moeburn/seansmeatthermometer/frzmain.jpg

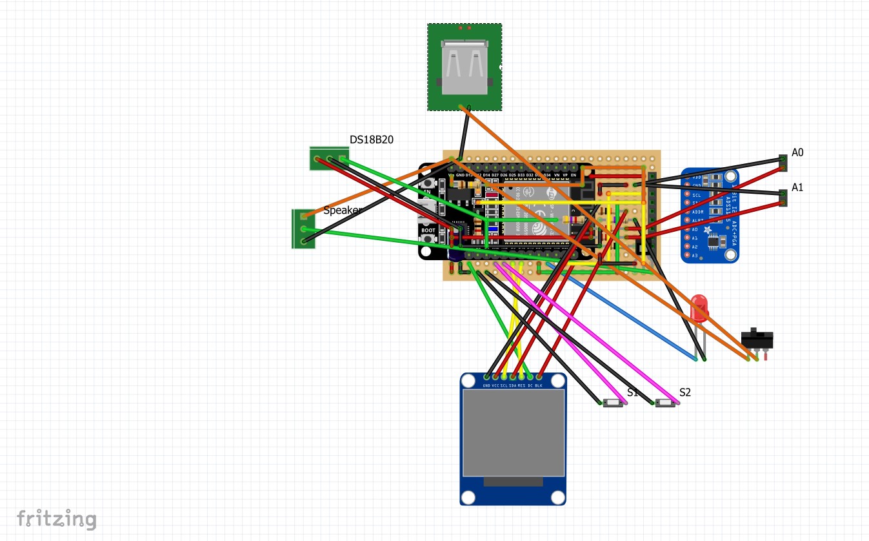
frzmain.jpg
