moeburn/seansmeatthermometer/frzLM386.jpg

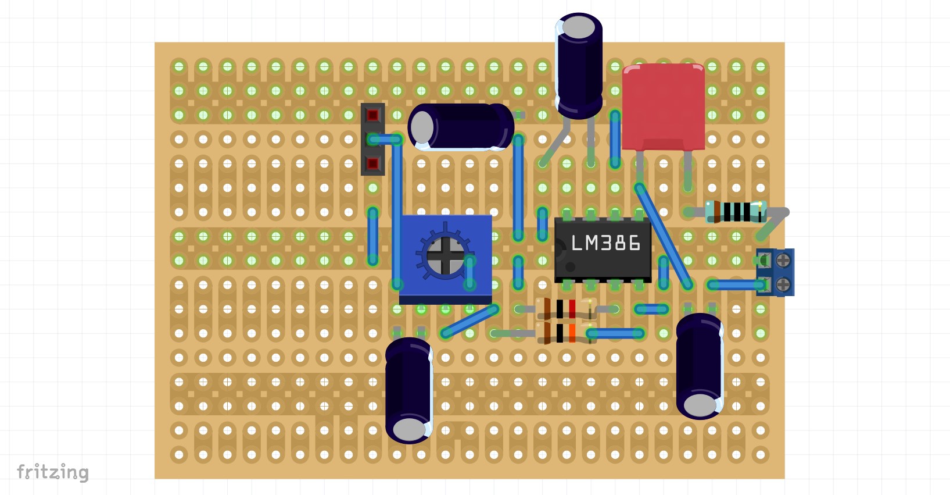
frzLM386.jpg
