moeburn/seansmeatthermometer/frzLM386schematic.jpg

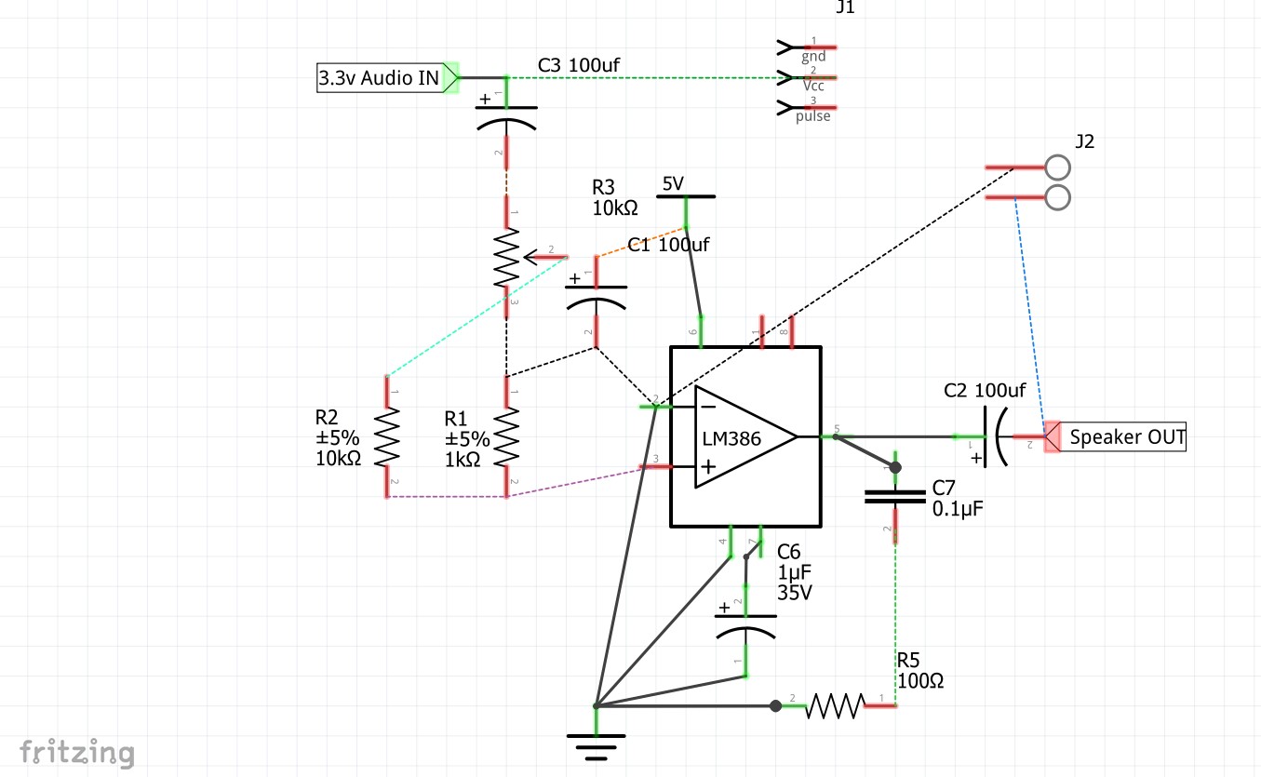
frzLM386schematic.jpg
