moeburn/seansmeatthermometer/(list of files, drawings)

Other design files:
lm386.fzz
sean.fzz
