moeburn/seansmeatthermometer/(commit log)

2024-06-27 debug stage 1
2024-07-01 fix steinhart-hart bug giving slightly incorrect temperatures
    apparently you actually have to input resistance in ohms, and not just any random-ass ADC count value, or you'll get temperatures but they'll be just a bit off. Who knew.
    [seanmeatthermometer.ino]
2024-07-03 Add LED mode
2024-08-13 Tidied up font display, fixed wifi bug, adjusted bat icon
    [seanmeatthermometer.ino]
2024-08-14 Fritzing schematic files
    [lm386.fzz, sean.fzz]
2024-08-14 Schematics and drawings
2024-08-17 fix mapf being long instead of double bug
    [seanmeatthermometer.ino]
